Wang-Derr/ARMIDUINO/Assembly_Instructions.md

# **AR*MID*U*I*NO** Assembly Guide

## Circuit Assembly

### Circuit Schematic

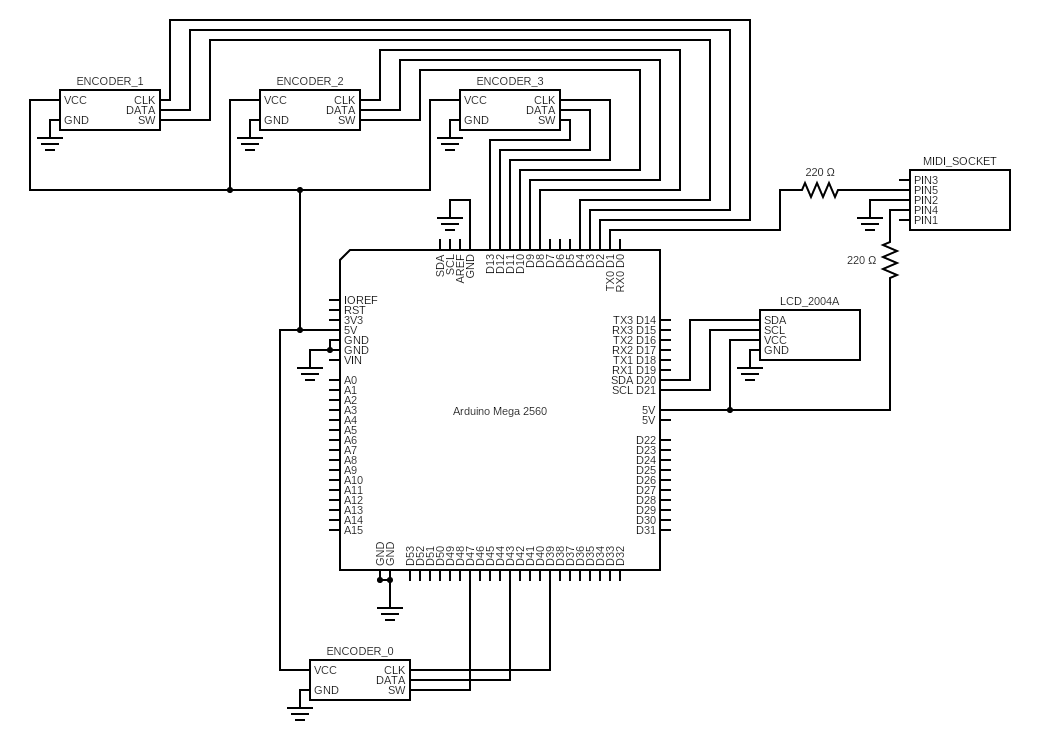
[picture p4: images/circuit.png]
circuit schematic
 \
**NOTE** follow this schematic in order to match what is written in the software. If  you prefer to use different pins, you will need to make those same adjustments in the code.

### MIDI Socket Pinout

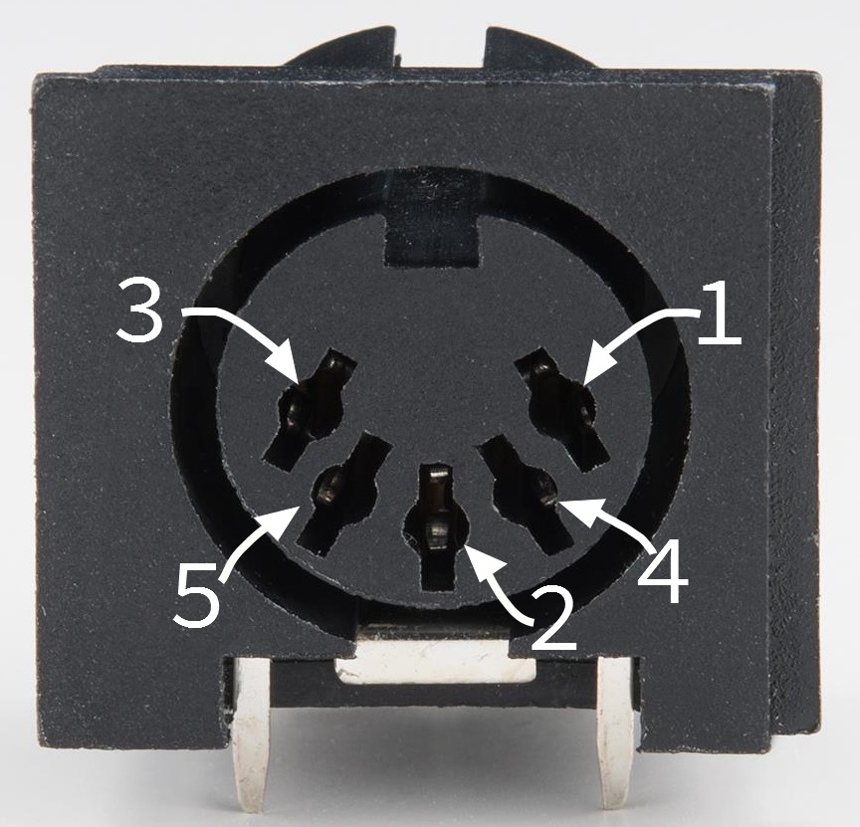
[picture p5: images/midi-labeled.jpg]
MIDI socket
 \
**NOTE** use this image as a reference for the pinout on a MIDI socket. The schematic above matches this pinout description. Since the pins you'll be soldering are on the reverse side, pin 3 will actually be on your right and therefore pin 1 will be on your left.

## Enclosure Assembly

### Components needed

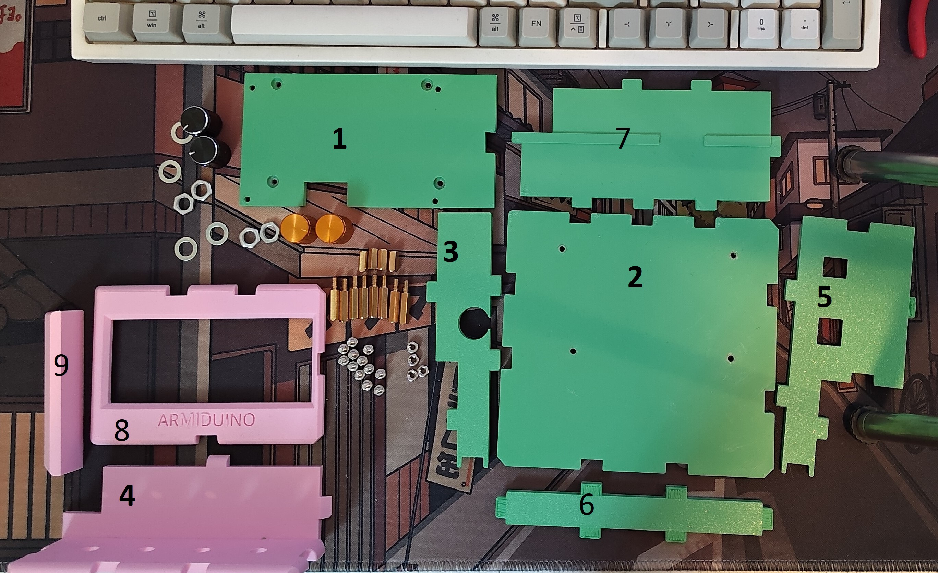
[picture p6: images/step_0.jpg]
Step 0
 \
**NOTE** all the parts shown are listed under the **Optional Parts** section in the [README.md](README.md).

### Step 1 - Install 8 of the M3 screws into part #1

Step 1

### Step 2 - Install All 8 15mm M3 standoffs

Step 2

### Step 3 - Grab your Arduino Mega

Step 3 \
**NOTE** your Arduino should be completely wired up at this point, so make sure you've tested it before putting it in the enclosure.

### Step 4 - Line up the standoffs on part #1 with the holes on your Arduino Mega

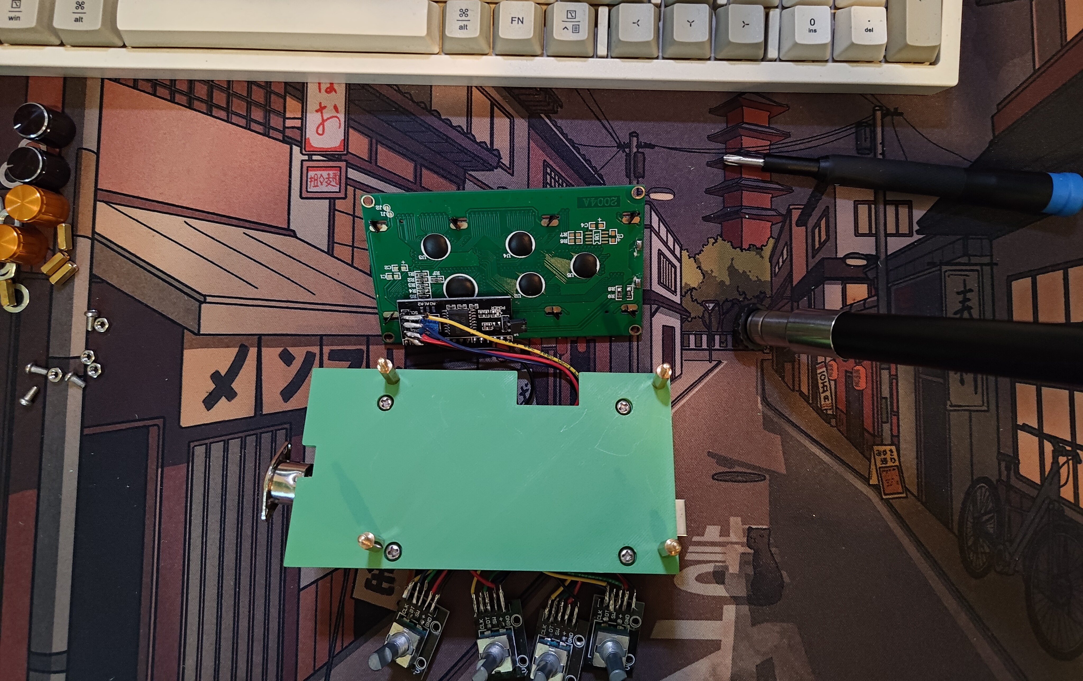
[picture p7: images/step_4.jpg]
Step 4


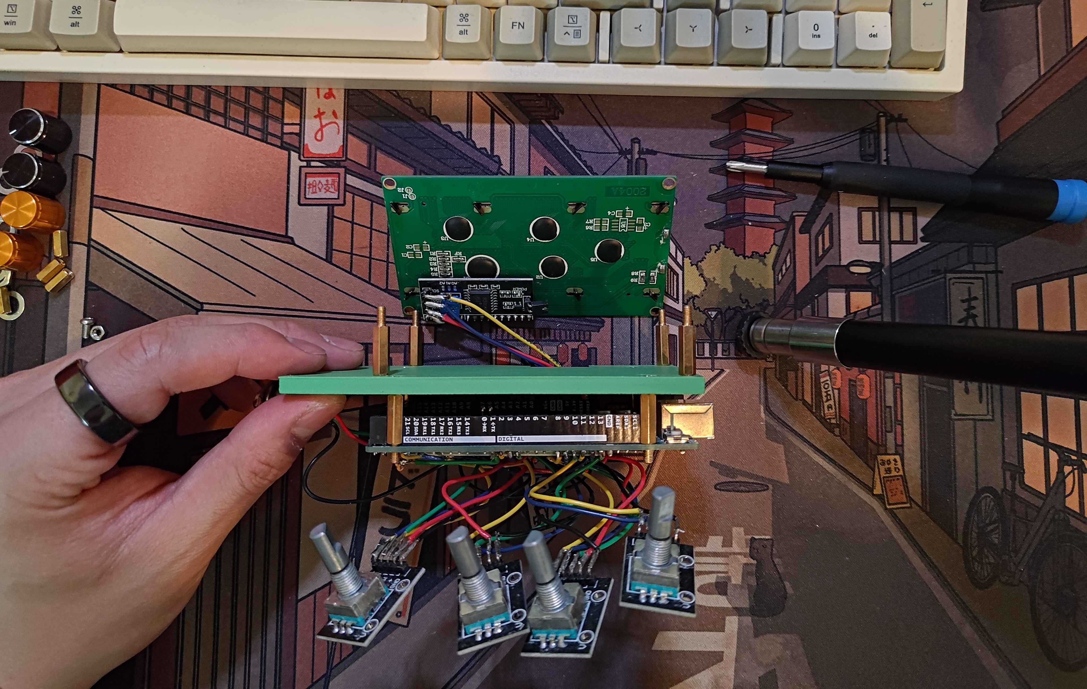
[picture p8: images/step_5.jpg]
Step 5
 \
**NOTE** this is what it should look like, you may need to twist some of the standoffs so that they fit between the headers on the Arduino Mega.

### Step 5 - Line up the other standoffs on part #1 with the holes on your LCD

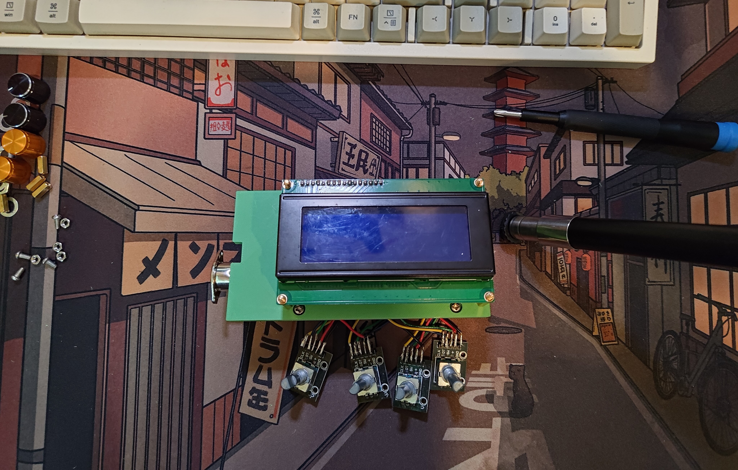
[picture p9: images/step_6.jpg]
Step 6


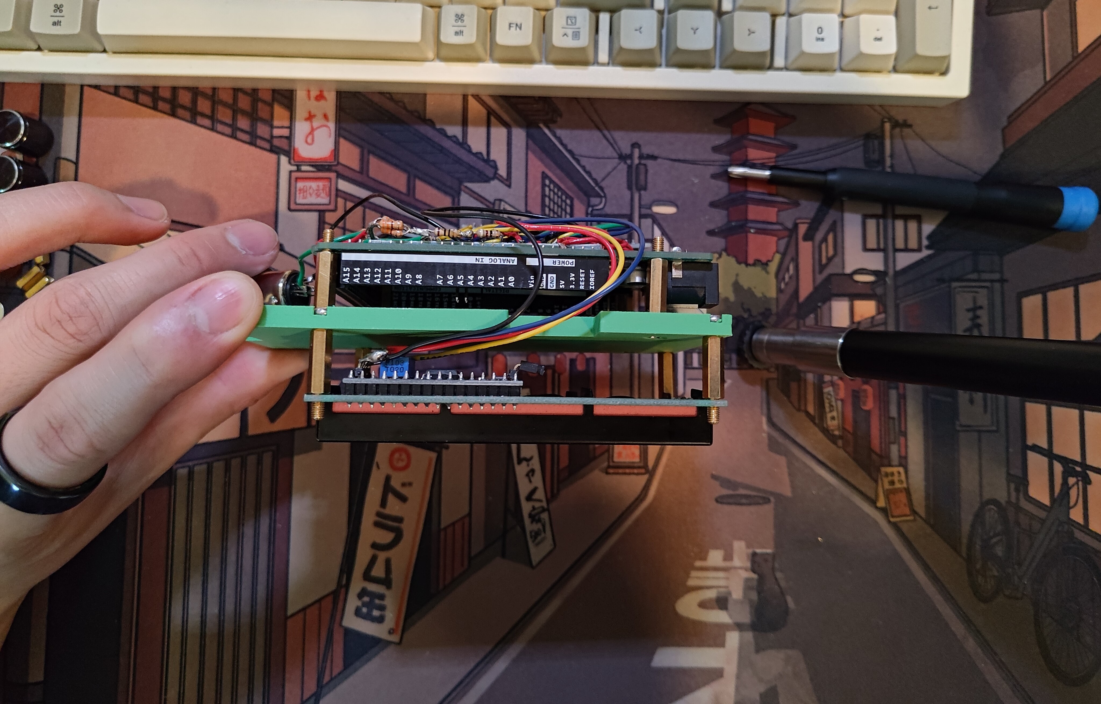
[picture p10: images/step_7.jpg]
Step 7
 \
**NOTE** this is how it should look at this step.

### Step 6 - Install the M3 nuts onto the ends of the standoffs holding your LCD in place

Step 8

### Step 7 - Flip it over and install the 10mm standoffs to the bottom of your Arduino Mega

Step 9 \
**NOTE** the resistors shown in this image may not seemingly match my instructions to use two 220 ohm resistors, but mathmatically they work out to be the same value; I was just short on 220 ohm resistors when I assembled the circuit and had to improvise.

### Step 8 - Install 4 M3 screws into the bottom of part #2

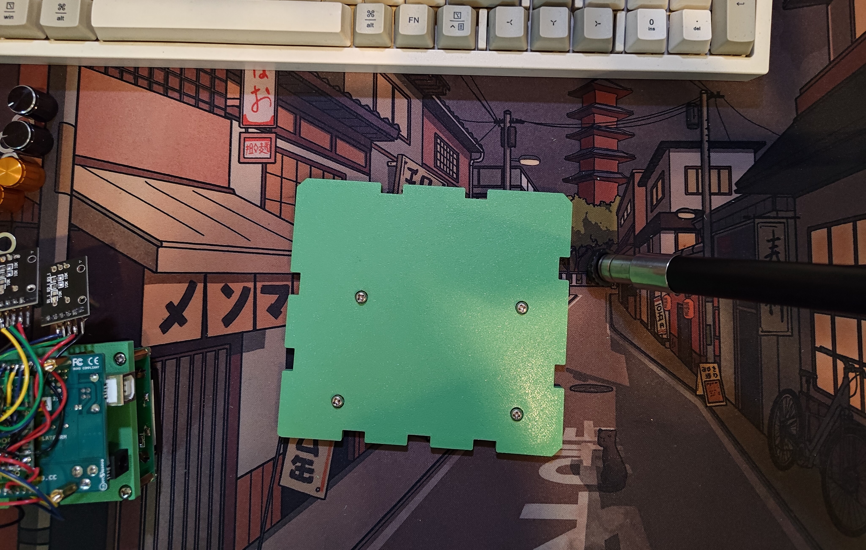
[picture p11: images/step_10.jpg]
Step 10


### Step 9 - Attach part #2 to the bottom of your Arduino Mega and tighten the M3 screws

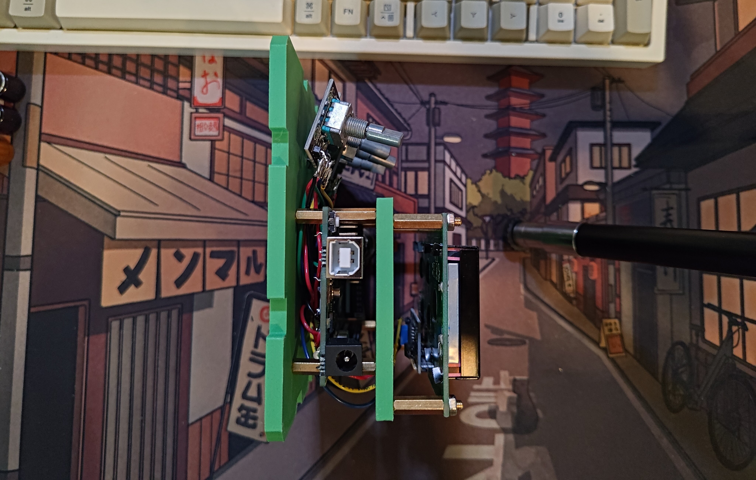
[picture p12: images/step_11.jpg]
Step 11


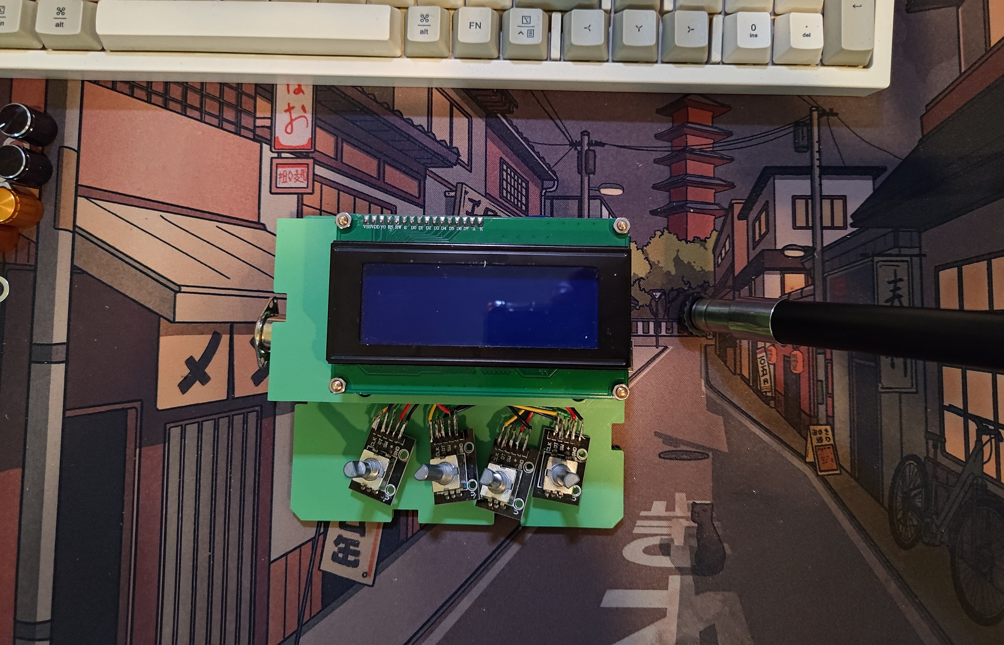
[picture p13: images/step_12.jpg]
Step 12


### Step 10 - Slide part #3 into place

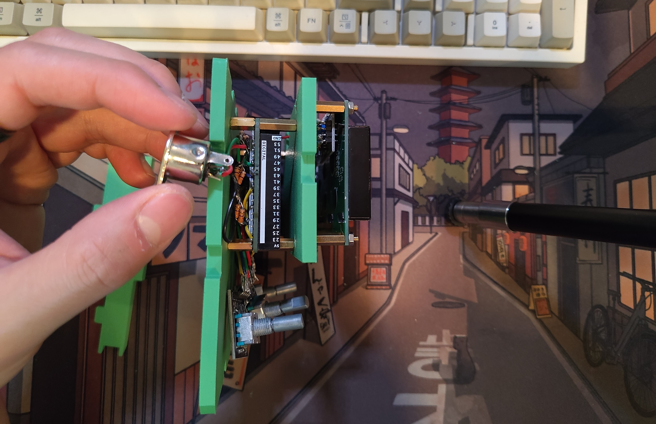
[picture p14: images/step_13.jpg]
Step 13
 \
**NOTE** make sure that you can pull the MIDI socket out a little bit so that part #3 can go around the wires.

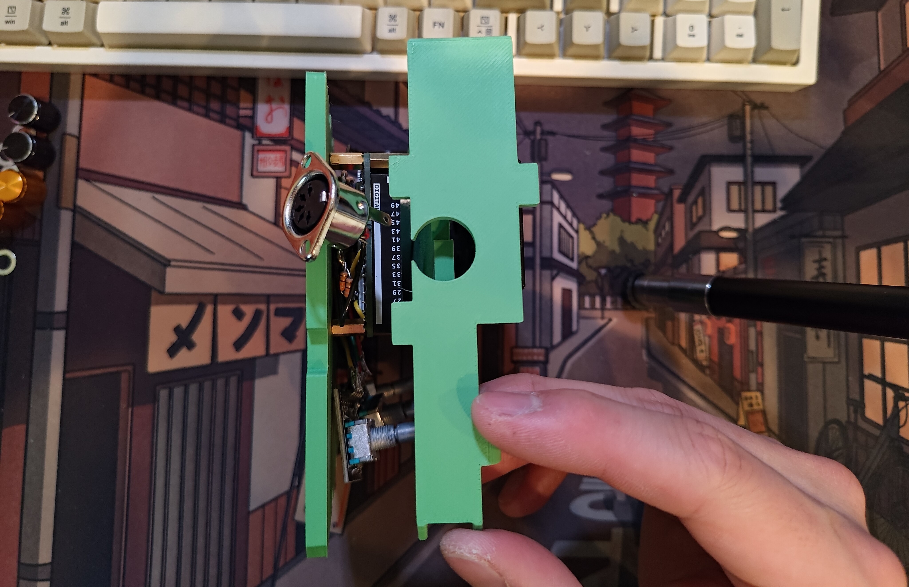
[picture p15: images/step_14.jpg]
Step 14
 \
**NOTE** part #3 was designed with the small opening in the bottom of the hold so that the enclosure could be assembled after all the wiring was put in place.

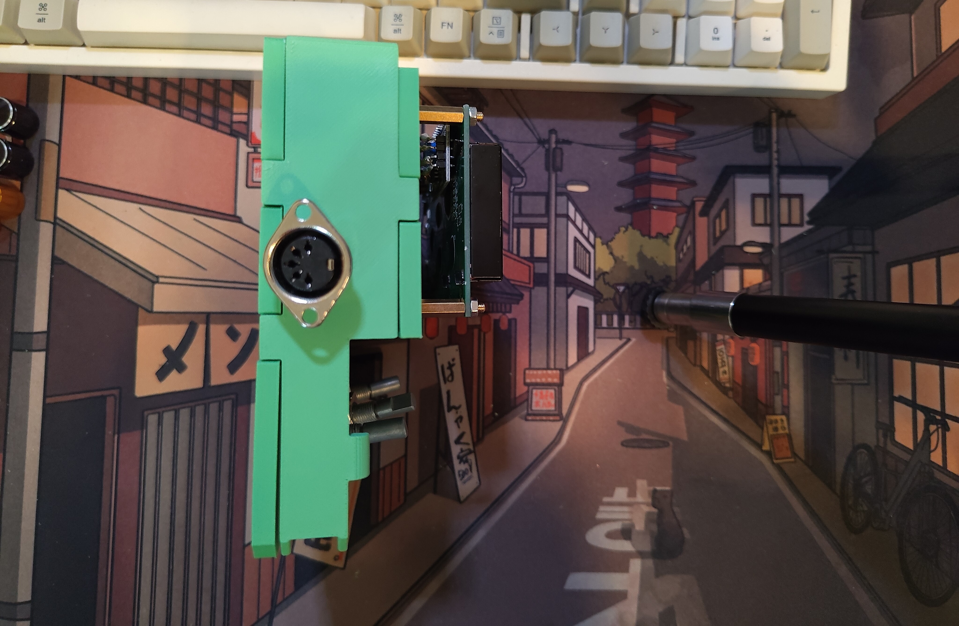
[picture p16: images/step_15.jpg]
Step 15


### Step 11 - Attach part #4 to the encoders

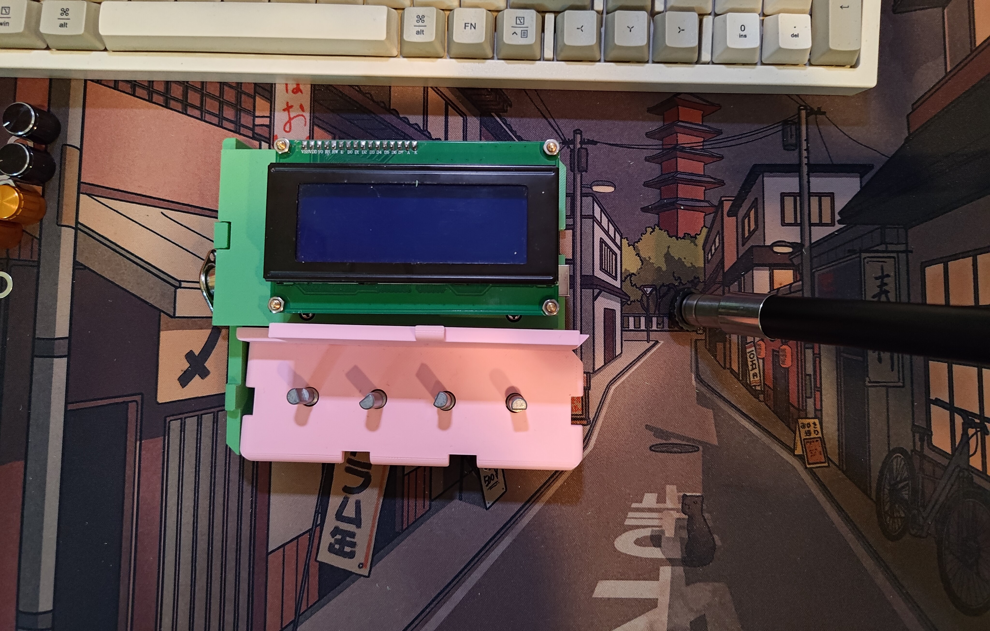
[picture p17: images/step_16.jpg]
Step 16


### Step 12 - Install the nuts onto the encoders to secure them in place

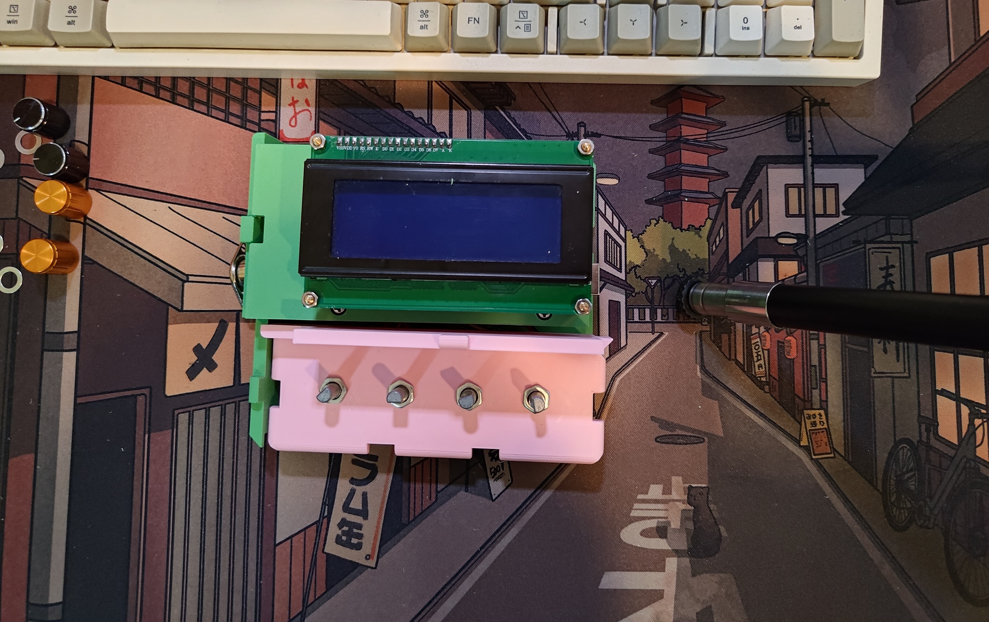
[picture p18: images/step_17.jpg]
Step 17


### Step 13 - Install part #5

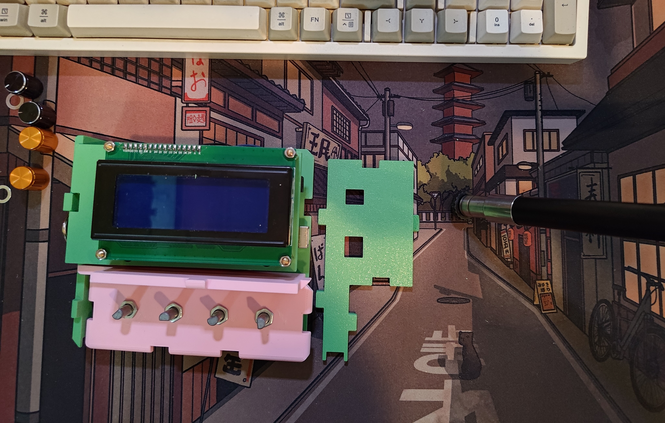
[picture p19: images/step_18.jpg]
Step 18


### Step 14 - Install part #6

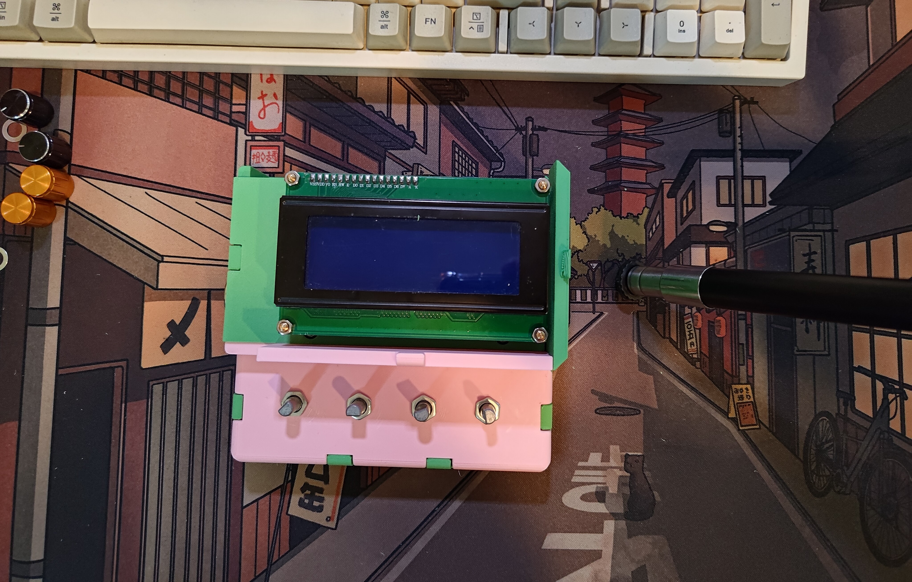
[picture p20: images/step_19.jpg]
Step 19
 \
**NOTE** part #6 fits in on the front of case.

### Step 15 - Install Part #7

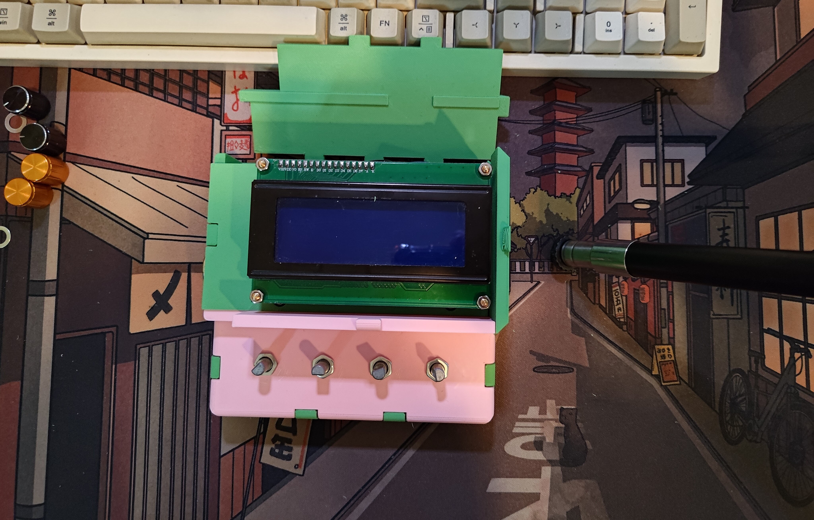
[picture p21: images/step_20.jpg]
Step 20


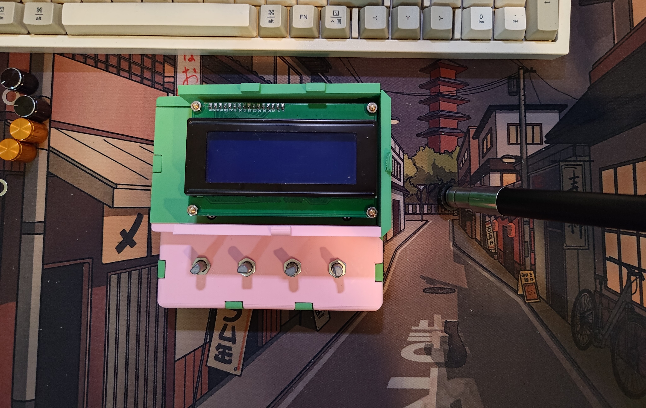
[picture p22: images/step_21.jpg]
Step 21


### Step 16 - Install Part #8

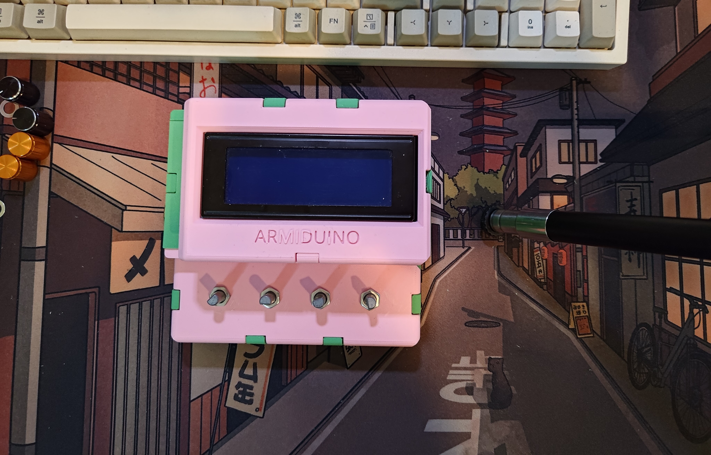
[picture p23: images/step_22.jpg]
Step 22


### Step 17 - Install Part #9

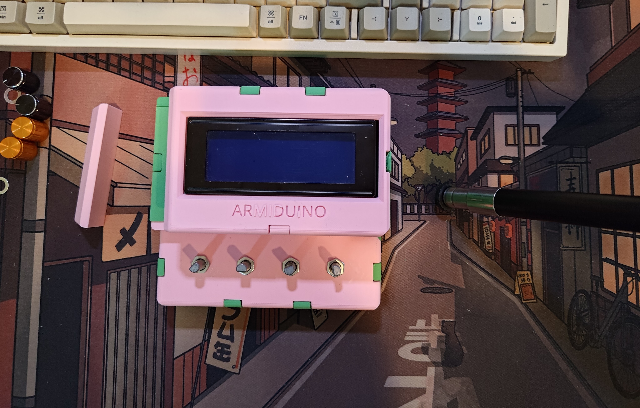
[picture p24: images/step_23.jpg]
Step 23


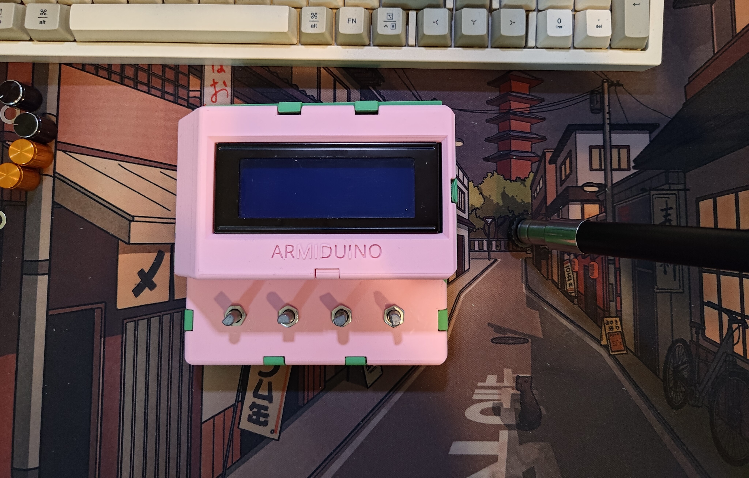
[picture p25: images/step_24.jpg]
Step 24


### Step 18 - Install the caps for the encoders

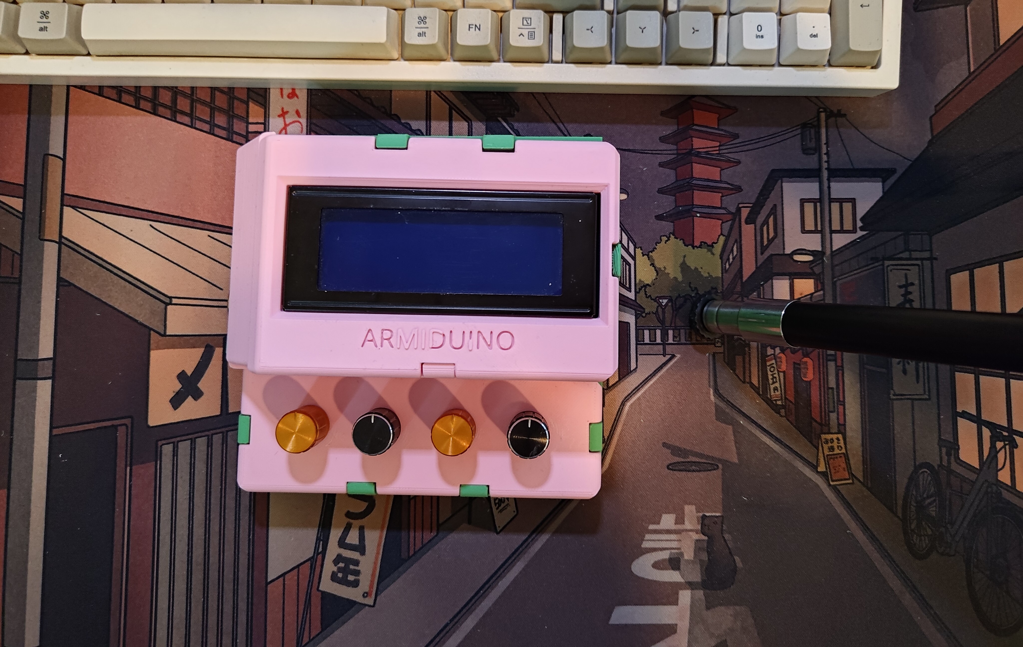
[picture p26: images/step_25.jpg]
Step 25


### If it all fits together, apply superglue or your preferred 3D print bonding method to hold it all together

**NOTE** you're going to want to test it all before permanently sealing it together. I would also recommend not sealing the bottom panel (part #2) to the rest of the enclosure since it's already held in place by the M3 screws.
