Wang-Derr/ARMIDUINO/(threads)

Thread 1 (2024-04-17):

hiduino

Wallirec, 2024-04-17:
Hello, great project!
Tell me, will your sketches work with Hiduino?
I need the sketch to work via USB

Wallirec, 2024-04-17:
The numbers on the display change but no messages appear. I don’t have a single encoder, maybe that’s why MIDI messages don’t go through USB.
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

Wang-Derr, 2024-04-18:
Interesting, how are you changing the numbers without encoders, I'm assuming using that number pad in the photo? The way the code runs is that you need to trigger a button press on _Encoder3_ in order to send the MIDI message, so if you're able to substitute a button press for that, it should work. It's currently mapped to digital pin 13.

Wang-Derr, 2024-04-18:
Glad it worked out!

Closed 2024-04-18.

Thread 2 (2024-04-24):

Arduino Pro Micro

Wallirec, 2024-04-24:
Wang-Derr, Hello! I wanted to make a compact controller and unknowingly bought an Aruduino micro with an ATmega32U4 controller. The sketch on the board works, the data is displayed on the LCD, but midi is not transmitted via USB, the Heduino firmware does not work on this board. Do you know how to make your USB sketch work on Arduino micro?

Wang-Derr, 2024-04-25:
ATmega32U4 based controllers (like the Arduino Micro) have native USB capabilities, so instead of using the Hiduino project, you're alternatives are to either use a MIDI jack like I did or to use the [MIDIUSB library](https://github.com/arduino-libraries/MIDIUSB) in place of the the _MIDI.h_ library that this project relies on. Depending on how comfortable you are writing code, it shouldn't be too difficult to swap in the MIDIUSB library, this is the reference for it on Arduino's website: https://reference.arduino.cc/reference/en/libraries/midiusb/.

Wallirec, 2024-04-25:
Unfortunately, I can't do this. We'll have to return to UNO and switch to a large building.

Closed 2024-04-25.

Thread 3 (2024-07-11):

Thank you for your hard work!

Wallirec, 2024-07-11:
Thank you for your hard work! Based on your sketch, I wrote my own, with great difficulty, since I could not find similar information anywhere. After trying several options with the Joystick and encoders, I settled on keyboard input. Since the Roland electric piano has 312 presets, the Arduino Pro Micro was enough for me.
Thank you again, I learned a lot from you (for example, how to use Progmem)!
Now I have access to all 312 presets and a choice of channels and drum sets on the Roland FP 30x (by default, only 57 presets).
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

Wang-Derr, 2024-07-11:
That's awesome! Glad that my project helped you along in some way.

Closed 2024-07-11.
