Wang-Derr/ARMIDUINO/(commit log)

2024-03-29 Fixed some typos, added instructional clarity, and changed the Assembly_Instructions.md file from CRLF to LF.
2024-04-24 Minor Revision: fix PC related issues and made some QoL improvements
    [MIDI_Program_Controller.ino, MIDI_Program_Controller_YAMAHA_DD75.ino]
